tjaworski997/whisli-sense/doc/screenshots/pl/radar.webp

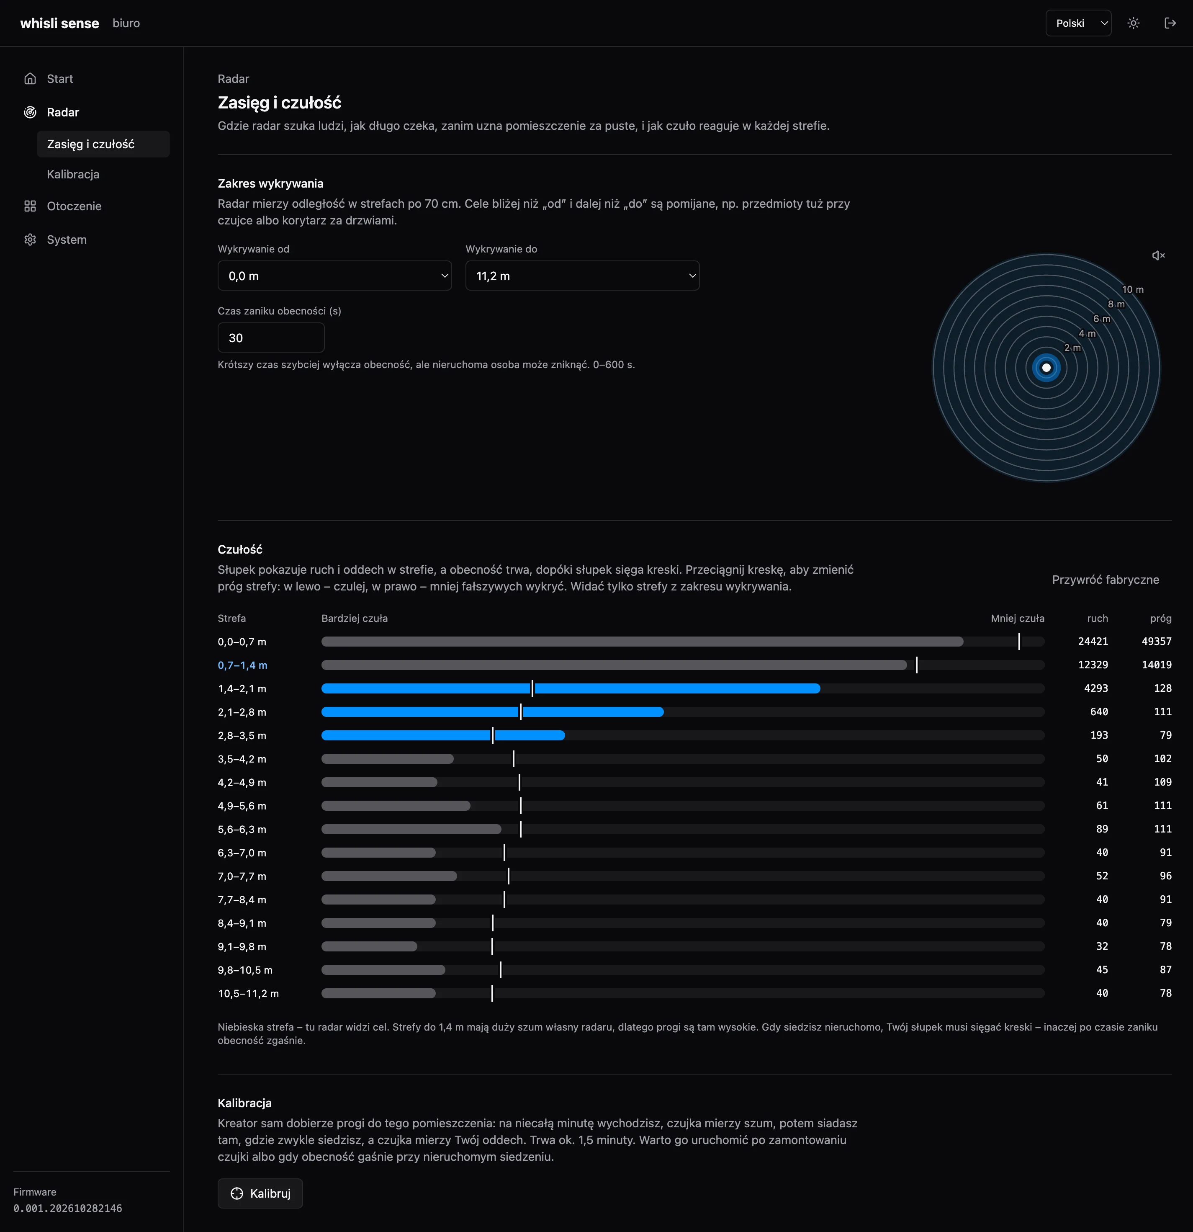
doc/screenshots/pl/radar.webp
