tjaworski997/whisli-sense/doc/screenshots/pl/sensors-table.webp

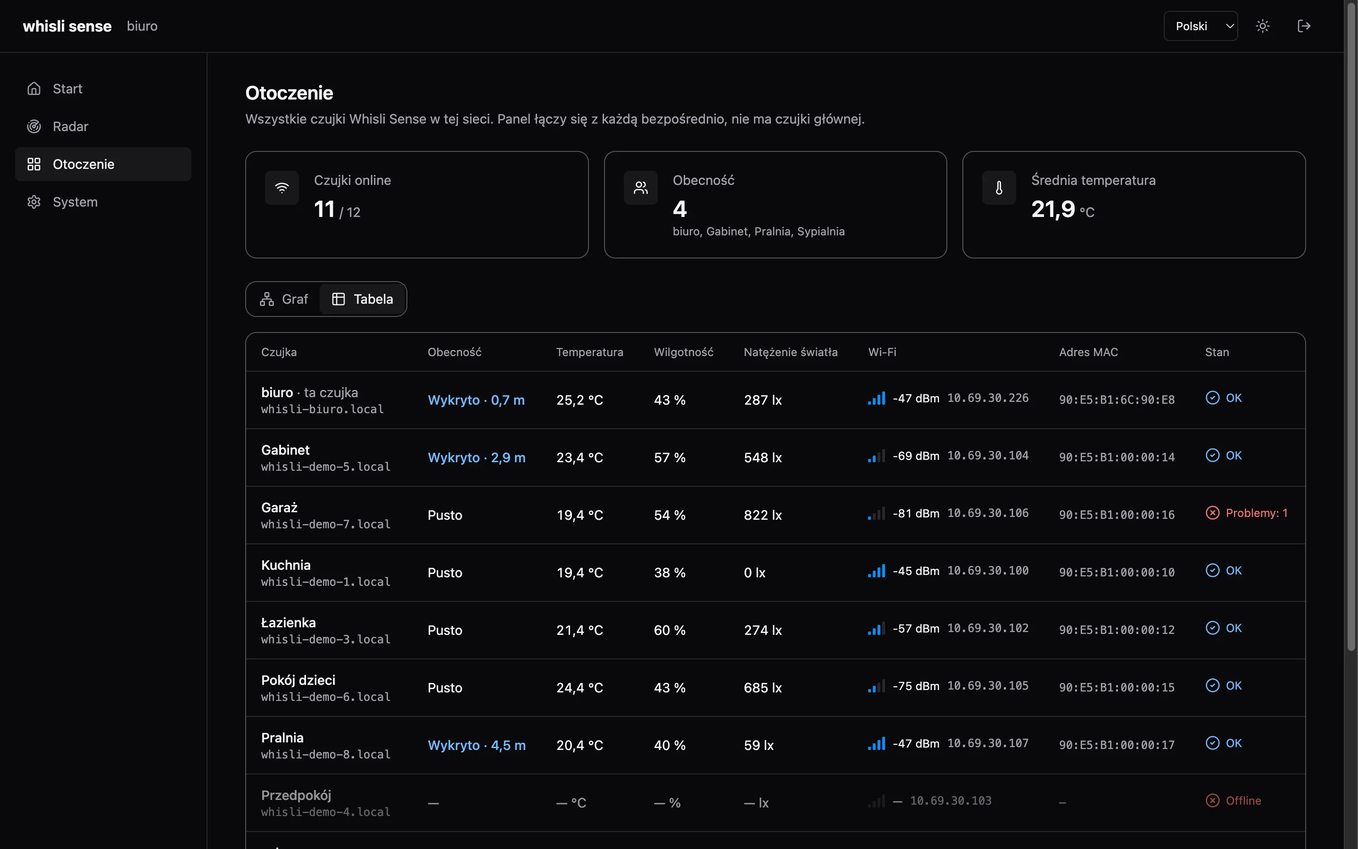
doc/screenshots/pl/sensors-table.webp
