tjaworski997/whisli-sense/doc/screenshots/pl/start.webp

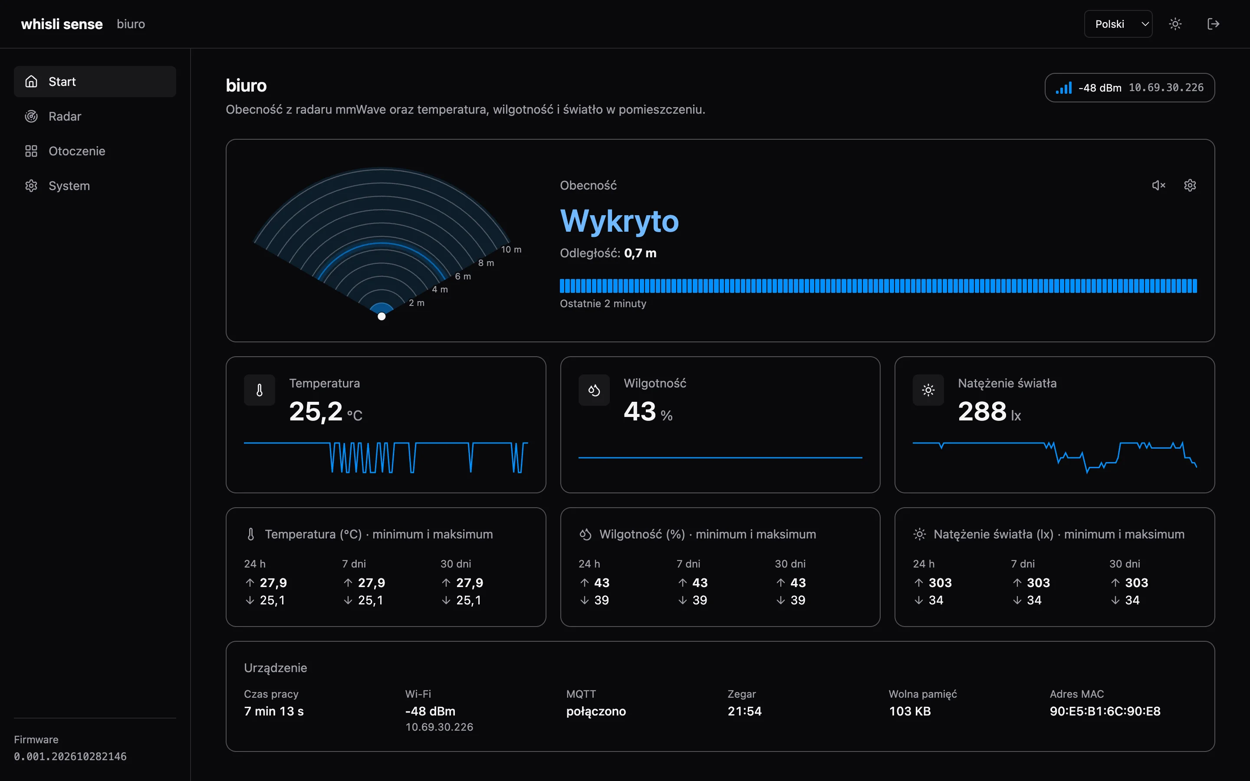
doc/screenshots/pl/start.webp
