tjaworski997/whisli-sense/hardware/enclosure/print/whisli-sense-obudowa.step

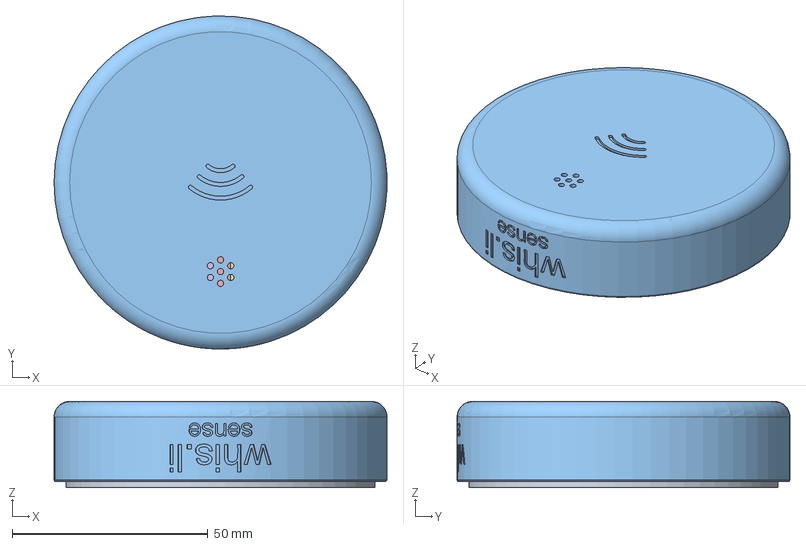
[picture p12: CAD file, 2026-10-30]
hardware/enclosure/print/whisli-sense-obudowa.step
85.0 x 85.0 x 22.0 mm
