tjaworski997/whisli-sense/hardware/enclosure/print/podstawa.stl

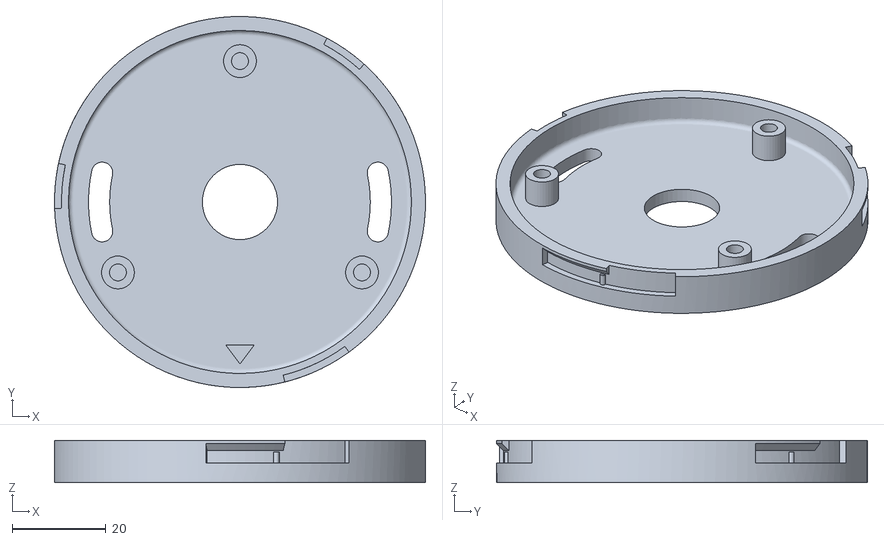
[picture p13: CAD file, 2026-10-30]
hardware/enclosure/print/podstawa.stl
79.0 x 79.0 x 9.00
