tjaworski997/whisli-sense/hardware/enclosure/print/pokrywa.stl

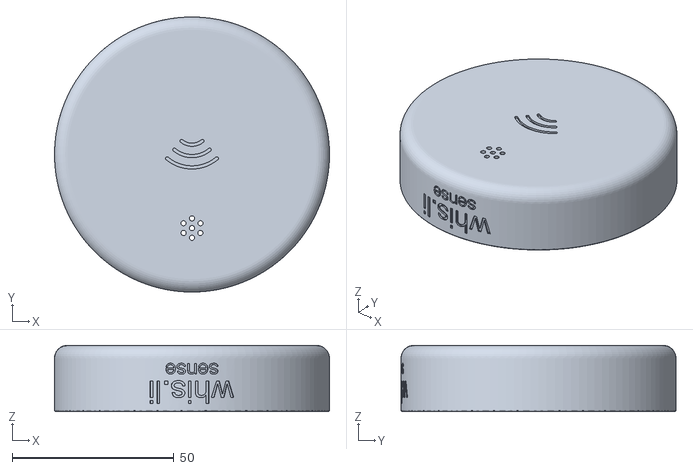
[picture p14: CAD file, 2026-10-30]
hardware/enclosure/print/pokrywa.stl
85.0 x 85.0 x 20.5
