tjaworski997/whisli-sense/hardware/enclosure/print/plytka.stl

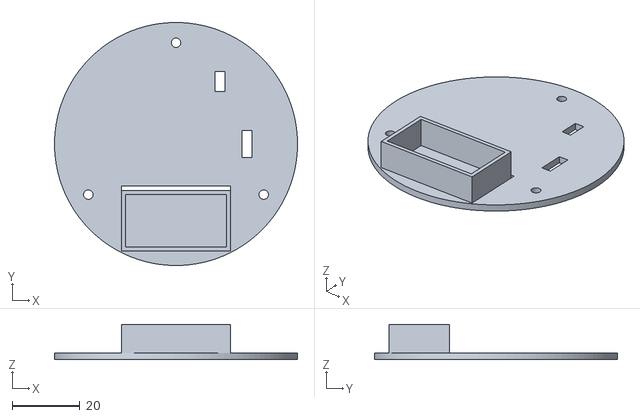
[picture p15: CAD file, 2026-10-30]
hardware/enclosure/print/plytka.stl
72.0 x 72.0 x 10.5
