tjaworski997/whisli-sense/doc/screenshots/pl/calibration.webp

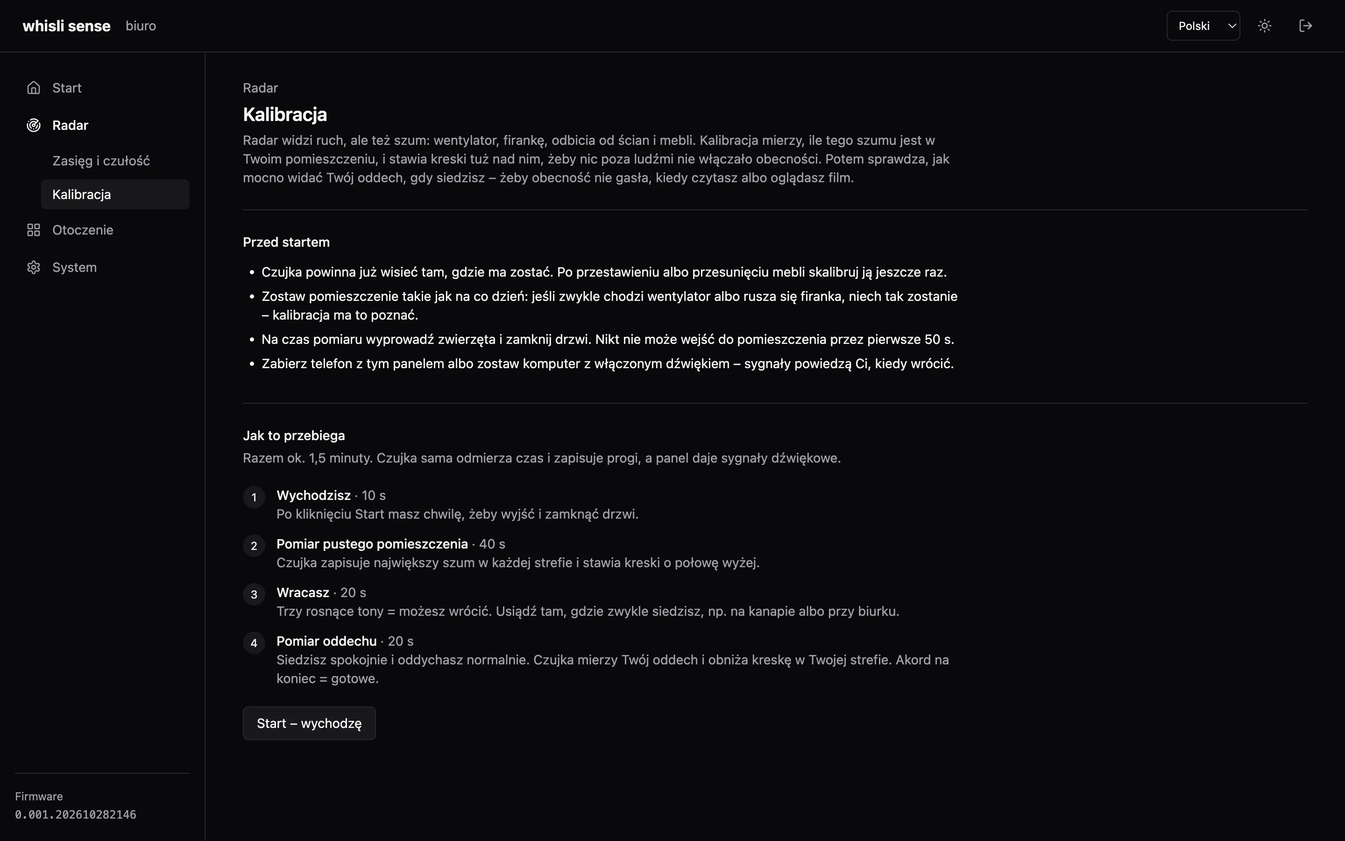
doc/screenshots/pl/calibration.webp
