tjaworski997/whisli-sense/hardware/pcb/whisli-sense.kicad_pcb

## KiCad design hardware/pcb/whisli-sense.kicad_pcb (2026-10-30)

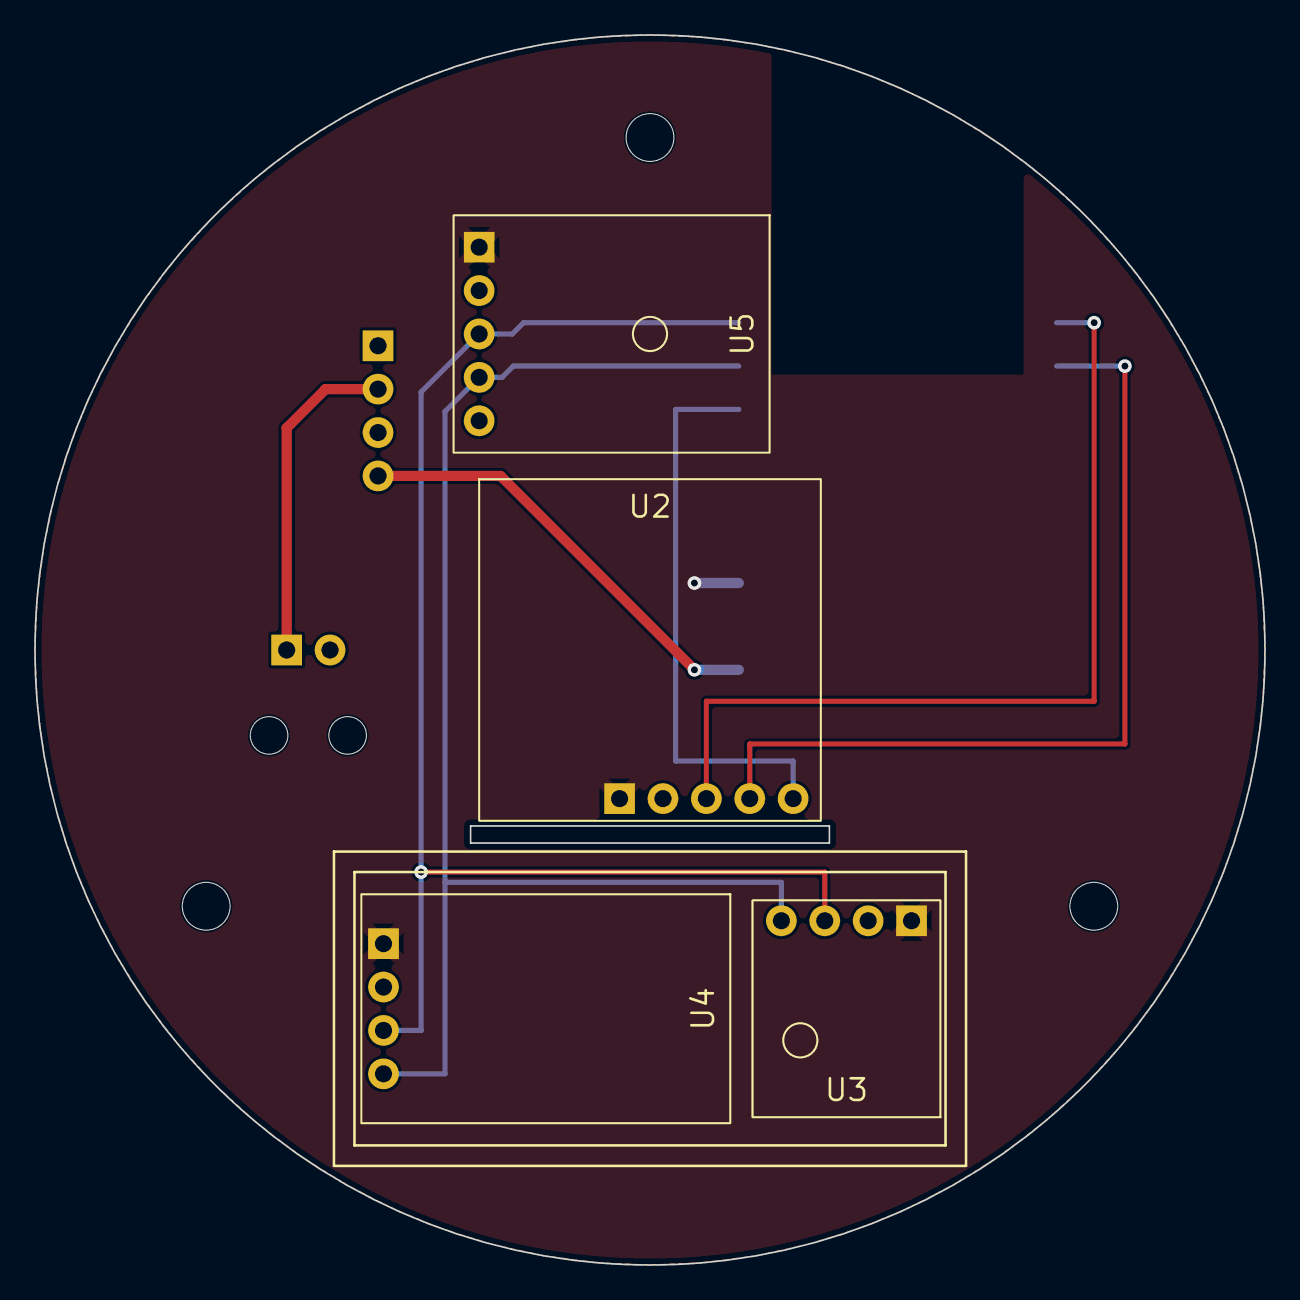
[picture p17: board whisli-sense.kicad_pcb from above]

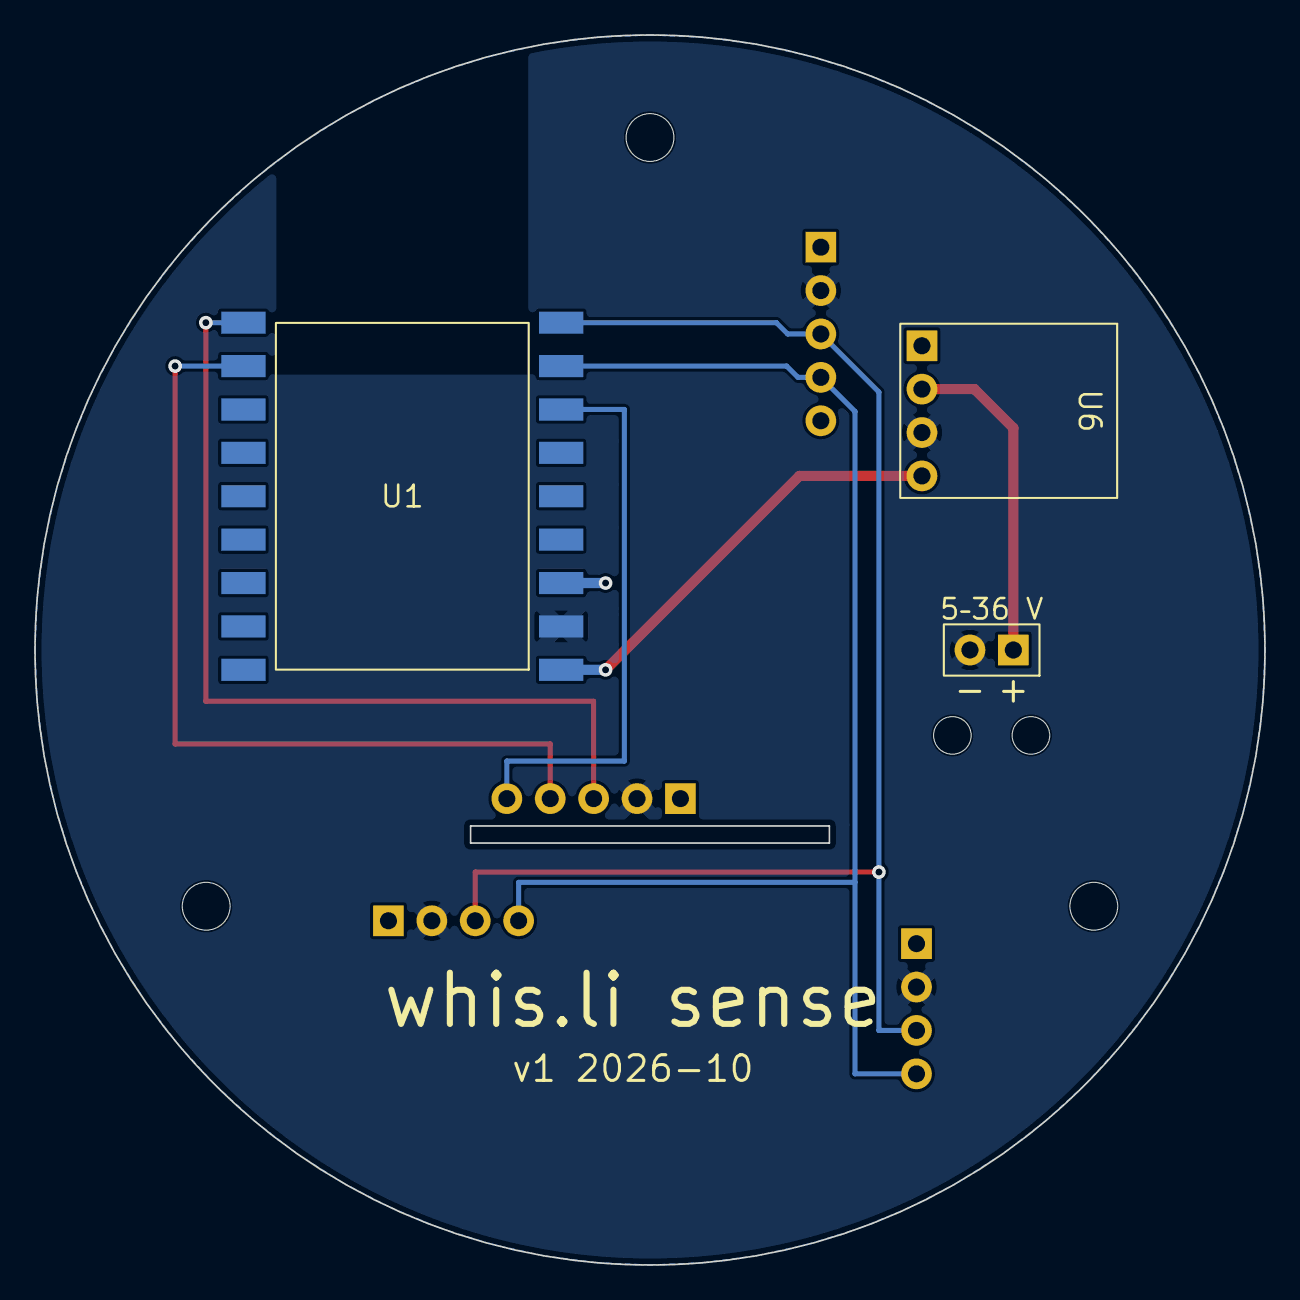
[picture p18: board whisli-sense.kicad_pcb from below]

Board: 2 copper layers, 72.0 x 72.0 mm, 12 parts (3 on the bottom side), 9 nets.

Parts:
H1, H2, H3, H4, H5: (no value)
J1: zasilanie 5-36 V
U1: ESP32-C3-Zero
U2: HMMD mmWave
U3: SHT3x
U4: SCD41
U5: BH1750 GY-302
U6: Pololu D36V6F5

Connections:
+3V3: U1.3V3, U2.3V3, U3.VIN, U4.VCC, U5.VCC
+5V: U1.5V, U6.VOUT
GND: J1.GND, U1.GND, U2.GND, U3.GND, U4.GND, U5.GND, U6.GND
RADAR_OUT: U1.IO3, U2.OT2
RADAR_RX: U1.IO6, U2.TX
RADAR_TX: U1.IO7, U2.RX
SCL: U1.IO5, U3.SCL, U4.SCL, U5.SCL
SDA: U1.IO4, U3.SDA, U4.SDA, U5.SDA
VIN: J1.VIN, U6.VIN
