tjaworski997/whisli-sense/(commit log)

2026-10-28 whisli sense – pierwsza wersja
    - firmware: radar HMMD z kalibracją progów, SHT30, BH1750, min/max z 24 h, 7 i 30 dni
    - Wi-Fi z punktem dostępowym do konfiguracji, mDNS i widok wszystkich czujek w sieci
    - MQTT z Home Assistant Discovery, aktualizacje przez Wi-Fi, dziennik zdarzeń, dioda LED
    - panel: start, radar, kalibracja, otoczenie (graf/tabela), dioda, diagnostyka; polski i angielski
    - README po angielsku i polsku ze zrzutami ekranu
2026-10-30 obudowa sufitowa: skrypt fusion – podstawa, płytka, pokrywa na bagnet, grawery
2026-10-30 obudowa: pliki stl i step do druku
    [plytka.stl, podstawa.stl, pokrywa.stl, whisli-sense-obudowa.step]
2026-10-30 płytka nośna: skrypt kicad – moduły na płasko, przetwornica pololu, miejsce na scd41
    [whisli-sense.kicad_pcb]
2026-10-30 płytka: napis whis.li sense, wersja i oznaczenie zasilania na sitodruku
    [whisli-sense.kicad_pcb]
2026-10-30 płytka: skrypt pakuje gerbery i wiercenia do zip pod zamówienie
    [whisli-sense.kicad_pcb]
2026-10-30 płytka: otwory odciążające przewód zasilania przy J1
    [whisli-sense.kicad_pcb]
